silvervest/simms/(threads)

Thread 1 (2024-11-26):

Status?

luciust, 2024-11-26:
So, what is the status - assuming this is 8/9bit 1MB/256kB design? I need 1MB no parity - do I need two 1Mx4 bit chips? Solder blob on 1M?

luciust, 2024-12-01:
Cool thanks, I was looking for a tested project that would allow me to upgrade RAM in Atari STE - it needs just that - 1MB no-parity RAM. Ordering PCBs then!

Closed 2024-12-31.

Thread 2 (2024-12-30):

Missing link - 18/CA9 to 1MB

luciust, 2024-12-30:
Hey, it seems that this are not connected on the PCB:

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

So far just this one seems to be off, measuring it again. Made a patch from and investingating futher :)

PS: Yeah I'm still on it!

silvervest, 2024-12-31:
Dang, good eye! That and the floating A9 line above it are leftovers from when I added the 1MB support but never clearly quite got there :)

Fixed in f8fbd1824436777fc3a2bb8cec8fb44150972ab2

Closed 2024-12-31.

Thread 3 (2025-01-01):

Is the wiring of DQ0-DQ3 without DQ4-DQ7 correct?

luciust, 2025-01-01:
Hi, I've been troubleshooting the solder job I made and realized that both chips have DQ0-DQ3 wired together while DQ4-DQ7 are not connected. Am I asking silly question or should the second chip be wired to DQ4-DQ7?

silvervest, 2025-01-01:
Not silly at all, I really messed that up... Not sure how I missed that when I redid the schematic, but it was late 2023 so who knows what I was thinking back then... sorry! Going to need some significant rerouting to work (or cut the DQ0-3 lines on U2 and bodge them to DQ4-7)
U2 should definitely be going to DQ4-7 so it can return bits 4-7. The only two pins that shouldn't be connected are A10-11, which are for larger RAM sizes (4/16mb)

luciust, 2025-01-01:
Hey, no worries, I just did the testing :) Would love to order next batch, so I can only cross fingers and hope you'll find time for re-routing, since I've got old Atari STE waiting for 1MB modułowa and spare FPM and EDO chips. In mean time I'll try to kill the vias and cut traces...

silvervest, 2025-01-02:
Okay! Fixed (f117b402cefebaa9924e2a99aa73c9cca03d1b8a) the U2 data lines going to DQ4-7 and rerouted everything. I moved to a smaller trace and via diameter (still within JLCPCB's capabilities) to give me some more room and make a neater board. Still two layer though.

Let me know how you get on, I can spend an evening in Kicad but I don't have the time to actually build and use these at the moment sadly

luciust, 2025-01-02:
Wow, that was quick, that's great. Let me test that and get back with results!

luciust, 2025-01-13:
Well, seems that FPMs 70 ns **do work fine** with the fixed revision. More testing needed but... I'm recommending you on the Atari ST group!
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

silvervest, 2025-01-13:
Ah that is awesome! Thanks for testing and confirming ❤️

luciust, 2025-01-14:
Thanks for you work on this, love that we have open hardware alternative. Tested the RAM for 2 hours with YART (Atari ST program) and it works fine. EDO testing is another thing and hardware dependand here, so I'll let you know.

Closed 2025-01-14.
