silvervest/simms/(commit log)

2024-12-31 connect CA9
    [bom.csv, designators.csv, positions.csv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]
2025-01-02 fix incorrect data line connections; reroute entire board with thinner traces for neatness
    [positions.csv, simms.kicad_pcb, simms.kicad_sch]
